Cyberman720/F1_GNSS/README.md

# F1_GNSS
Repo for developing the F1_Engine
The objective of this project is to develop a basic L1 GPS only receiver.

The steps are as follows:
  learn how the basics of GNSS and specifically GPS work from a theroy aspect.
    https://dsp.stackexchange.com/questions/91829/cdma-using-bpsk-demodulation
  
  prototype a GNSS siluation program in python.
    This has been an amazing resource for this:
    https://natronics.github.io/blag/2014/gps-prn/

  Learn about PCB design and what is required for really high frequency operation
    https://www.ti.com/amplifier-circuit/analog-engineers-pocket-reference-guide.html
    (also read the attached documents in the repo)

  Develop a working, reliable GPS only demodulation PCB
    https://easyeda.com/
    https://jlcpcb.com/parts?spm=Jlcpcb.smttopic

  Intergrate with arduino

  determine if I can run the engine direct on the arduino or if i need to process things on an external Rasberry pi
