Cyberman720/F1_GNSS/PCB_Designs/MK-IV/Screenshot 2025-08-05 094551.png

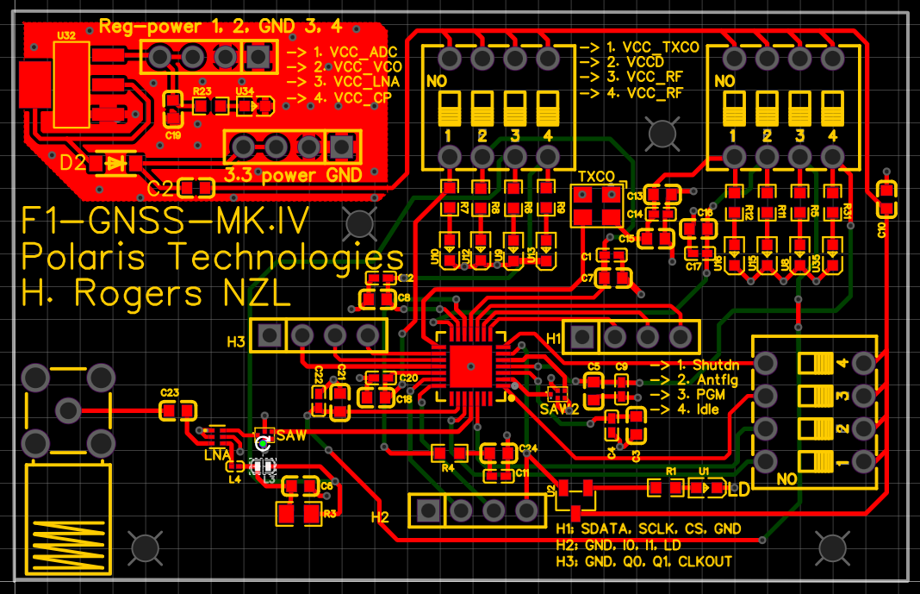
PCB_Designs/MK-IV/Screenshot 2025-08-05 094551.png
