Cyberman720/F1_GNSS/PCB_Designs/Mk_II/PCB_PCB_GNSS_F1_MK_II_2025-05-27.png

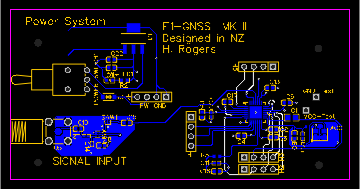
PCB_Designs/Mk_II/PCB_PCB_GNSS_F1_MK_II_2025-05-27.png
