Cyberman720/F1_GNSS/PCB_Designs/MK-IV/9117512A20250805.xlsx

Designator | Name | Footprint | Quantity
U6 | BWSMA-JWE | SMA-TH_BWSMA-JWE | 1
