Cyberman720/F1_GNSS/PCB_Designs/Mk_II/BOM_MKII-Diagram_2025-05-27.csv

ID | Name | Designator | Footprint | Quantity | Manufacturer Part | Manufacturer | Supplier | Supplier Part | Price | Pins | Contributor | JLCPCB Part Class
1 | 100nF | C1,C2,C3,C4,C5,C6,C10 | C0603 | 7 | CC0603KRX7R9BB104 | YAGEO(国巨) | LCSC | C14663 | 0.002 | 2 |  | Basic Part
2 | 10nF | C7 | C0603 | 1 | GRT1885C1E103FA02D | muRata(村田) | LCSC | C3836718 | 0.044 | 2 | lcsc | Extended Part
3 | 3pF | C8 | C0603 | 1 | CC0603BRNPO9BN3R0 | YAGEO(国巨) | LCSC | C519105 | 0.004 | 2 | LCSC | Extended Part
4 | 100pF | C9 | C0402 | 1 | CGA2B2C0G1H101JT0Y0F | TDK | LCSC | C76699 | 0.009 | 2 |  | Extended Part
5 | 27pF | C11 | C0402 | 1 | 0402N270J500CT | Walsin(华新科) | LCSC | C295973 | 0.001 | 2 | LCSC | Extended Part
6 | 22uF | C12 | C0603 | 1 | CL10A226MQ8NRNC | SAMSUNG(三星) | LCSC | C59461 | 0.009 | 2 |  | Basic Part
7 | 2pF | C13 | C0201 | 1 | 0201CG2R0C500NT | FH(风华) | LCSC | C233263 | 0.001 | 2 | LCSC | Extended Part
8 | SM4007PL | D1 | SOD-123F_L2.8-W1.8-LS3.7-RD | 1 | SM4007PL | MDD(辰达半导体) | LCSC | C64898 | 0.005 | 2 |  | Basic Part
9 | 2.54-1*4P母 | H1,H2,H3,H4,H5 | HDR-TH_4P-P2.54-V-F | 5 | 2.54-1*4P母 | BOOMELE(博穆精密) | LCSC | C2718488 | 0.047 | 4 | LCSC | Extended Part
10 | SAFEB1G57KE0F00R15 | L1 | FILTER-SMD_5P-L1.4-W1.1-L_HDF1588E-B2 | 1 | SAFEB1G57KE0F00R15 | muRata(村田) | LCSC | C91645 | 0.138 | 5 |  | Extended Part
11 | 10nH | L2 | L0402 | 1 | LQG15WZ10NJ02D | muRata(村田) | LCSC | C3911026 | 0.029 | 2 | lcsc | Extended Part
12 | 20pF | R1 | C0402 | 1 | TCC0402COG200J500AT | CCTC(三环) | LCSC | C880615 | 0.001 | 2 | lcsc | Extended Part
13 | 20kΩ | R2 | RES-TH_BD9.0-L31.5-P35.50-D0.8 | 1 | EWWR0008J20K0T9 | RESI(开步睿思) | LCSC | C349029 | 0.478 | 2 | LCSC | Extended Part
14 | 10kΩ | R23 | R0603 | 1 | 0603WAF1002T5E | UNI-ROYAL(厚声) | LCSC | C25804 | 0.001 | 2 |  | Basic Part
15 | ST-0-102-C03-N003-RS | SW1 | SW-TH_ST-0-102-C03-N003-RS | 1 | ST-0-102-C03-N003-RS | YUEN FUNG(源丰) | LCSC | C1788489 | 0.681 | 5 | LCSC | Extended Part
16 | - | U1 | QFN-28_L5.0-W5.0-P0.50-BL-EP3.3 | 1 | MAX2769BETI/V+T | ADI(亚德诺)/MAXIM(美信) | LCSC | C118482 | 3.757 | 29 | LCSC | Extended Part
17 | 470pF | U2,U6,U11 | CAP-SMD_L8.1-W6.0-LS11.4 | 3 | SMDY13225Y5P471K0 | STE(松田) | LCSC | C20625786 | 0.052 | 2 | lcsc | Extended Part
18 | AMS1117-3.3_C347222 | U3 | SOT-223-4_L6.5-W3.5-P2.30-LS7.0-BR | 1 | AMS1117-3.3 | UMW(友台半导体) | LCSC | C347222 | 0.04 | 4 | LCSC | Extended Part
19 | 470pF | U4 | C0402 | 1 | C1005NP02A471J050BA | TDK | LCSC | C3906083 | 0.017 | 2 | lcsc
20 | BWSMA-JWE | U5 | SMA-TH_BWSMA-JWE | 1 | BWSMA-JWE | BAT WIRELESS(蝙蝠无线) | LCSC | C5250065 | 0.824 | 5 | lcsc | Extended Part
21 | 16.368MHz | U8 | CRYSTAL-SMD_4P-L5.0-W3.2-BL | 1 | SA53216CF35HLR | CTS(西迪斯) | LCSC | C7071141 | 1.508 | 4 | lcsc | Extended Part
22 | AT2659 | U10 | DFN-6_L1.6-W1.0-P0.55-BL | 1 | AT2659 | 杭州中科微 | LCSC | C92450 | 0.102 | 6 | 立创EDA官方封装库 | Extended Part
23 | NCD0603Y5 | U34 | LED0603-RD | 1 | NCD0603Y5 | 国星光电 | LCSC | C7429912 | 0.007 | 2 | lcsc | Extended Part
