Cyberman720/F1_GNSS/PCB_Designs/Mk-I/BOM_GNSS-F1_2025-04-29.csv

ID | Name | Designator | Footprint | Quantity | Manufacturer Part | Manufacturer | Supplier | Supplier Part | Price | Pins | 3DModel | Contributor | JLCPCB Part Class | Value | link
1 | C0805 | C1 | C0805 | 1 | CL21B103KBANNNC | SAMSUNG(三星) | LCSC | C1710 | 0.006 | 2 | C0805_L2.0-W1.3-H1.3 | lcsc | Basic Part | 10nF | https://lcsc.com/eda_search?q=C1710&%26type=1&ref=editor
2 | C0603 | C15,C16,C17,C18,C19 | C0603 | 5 | 0603B471K500NT | FH(风华) | LCSC | C1620 | 0.003 | 2 | C0603_L1.6-W0.8-H0.8 | lcsc | Basic Part | 470pF | https://lcsc.com/eda_search?q=C1620&%26type=1&ref=editor
3 | SOD-123F_L2.8-W1.8-LS3.7-RD | D3,D1,D2 | SOD-123F_L2.8-W1.8-LS3.7-RD | 3 | SM4007PL | MDD(辰达半导体) | LCSC | C64898 | 0.005 | 2 | SOD-123FL_L2.8-W1.8-LS3.7-RD-1 | lcsc | Basic Part |  | https://lcsc.com/eda_search?q=C64898&%26type=1&ref=editor
4 | Header-Female-2.54_1x2 | P2,P1 | HDR-TH_2P-P2.54-V-F | 2 | 2.54-1*2P母 | BOOMELE(博穆精密) | LCSC | C49661 | 0.037 | 2 | HDR-TH_2P-P2.54-F-LI-1X2P | lcsc | Extended Part |  | https://item.szlcsc.com/426418.html
5 | R0603 | R5 | R0603 | 1 | 0603WAF2002T5E | UNI-ROYAL(厚声) | LCSC | C4184 | 0.001 | 2 | R0603 | lcsc | Basic Part | 20kΩ | https://lcsc.com/eda_search?q=C4184&%26type=1&ref=editor
6 | C0402 | C20 | C0402 | 1 | 0402CG101J500NT | FH(风华) | LCSC | C1546 | 0.001 | 2 | C0402_L1.0-W0.5-H0.5 | lcsc | Basic Part | 100pF | https://lcsc.com/eda_search?q=C1546&%26type=1&ref=editor
7 | C0402 | C21 | C0402 | 1 | 0402CG200J500NT | FH(风华) | LCSC | C1554 | 0.001 | 2 | C0402_L1.0-W0.5-H0.5 | lcsc | Basic Part | 20pF | https://lcsc.com/eda_search?q=C1554&%26type=1&ref=editor
8 | 2.54-1*4P母 | H2,H3,H1 | HDR-TH_4P-P2.54-V-F | 3 | 2.54-1*4P母 | BOOMELE(博穆精密) | LCSC | C2718488 | 0.046 | 4 | HDR-TH_4P-P2.54-F-LI-1X4P | LCSC | Extended Part |  | https://item.szlcsc.com/523021.html
9 | C0603 | C22 | C0603 | 1 | CL10A226MQ8NRNC | SAMSUNG(三星) | LCSC | C59461 | 0.008 | 2 | C0603_L1.6-W0.8-H0.8 | lcsc | Basic Part | 22uF | https://lcsc.com/eda_search?q=C59461&%26type=1&ref=editor
10 | LED0603-RD | PW-LED | LED0603-RD | 1 | NCD0603Y5 | 国星光电 | LCSC | C7429912 | 0.007 | 2 | LED0603-RD | lcsc | Extended Part |  | https://lcsc.com/eda_search?q=C7429912&%26type=1&ref=editor
11 | R0603 | R2 | R0603 | 1 | 0603WAF1002T5E | UNI-ROYAL(厚声) | LCSC | C25804 | 0.001 | 2 | R0603 | lcsc | Basic Part | 10kΩ | https://lcsc.com/eda_search?q=C25804&%26type=1&ref=editor
12 | L0402 | L2 | L0402 | 1 | LQG15WZ10NJ02D | muRata(村田) | LCSC | C3911026 | 0.034 | 2 | L0402_L1.0-W0.5-H0.5_BEAD | lcsc | Extended Part | 10nH | https://lcsc.com/eda_search?q=C3911026&%26type=1&ref=editor
13 | C0201 | C14 | C0201 | 1 | 0201CG2R0C500NT | FH(风华) | LCSC | C233263 | 0.001 | 2 | C0201_L0.6-W0.3-H0.3 | lcsc | Extended Part | 2pF | https://lcsc.com/eda_search?q=C233263&%26type=1&ref=editor
14 | 100nF | C13,C2,C3,C4,C5,C6,C10 | C0603 | 7 | CC0603KRX7R9BB104 | YAGEO(国巨) | LCSC | C14663 | 0.002 | 2 | C0603_L1.6-W0.8-H0.8 | lcsc | Basic Part |  | https://item.szlcsc.com/362304.html
15 | 2462 | BAT1,BAT2 | BAT-TH_2P-P14.50_2462 | 2 | 2462 | Keystone | LCSC | C3029547 | 1.375 | 2 | BAT-TH_2P-P14.50_2462 | lcsc | Extended Part |  | https://atta.szlcsc.com/upload/public/pdf/source/20220627/187200C29C302DEABB66D4671A482C2E.pdf
16 | 3pF | C8 | C0603 | 1 | CC0603BRNPO9BN3R0 | YAGEO(国巨) | LCSC | C519105 | 0.004 | 2 | C0603_L1.6-W0.8-H0.8 | LCSC | Extended Part |  | https://item.szlcsc.com/362304.html
17 | 27pF | C11 | C0402 | 1 | 0402N270J500CT | Walsin(华新科) | LCSC | C295973 | 0.001 | 2 | C0402_L1.0-W0.5-H0.5 | LCSC | Extended Part |  | https://item.szlcsc.com/15869.html
18 | SAFEB1G57KE0F00R15 | SAW | FILTER-SMD_5P-L1.4-W1.1-L_HDF1588E-B2 | 1 | SAFEB1G57KE0F00R15 | muRata(村田) | LCSC | C91645 | 0.148 | 5 | FILTER-SMD_5P-L1.4-W1.1-L_HDF1588E-B2 | LCSC | Extended Part |  | https://atta.szlcsc.com/upload/public/pdf/source/20191209/C468489_0AC4193B38E9111468D3A091E4B3D1AF.pdf
19 | ST-0-102-C03-N003-RS | POWER-SWITCH | SW-TH_ST-0-102-C03-N003-RS | 1 | ST-0-102-C03-N003-RS | YUEN FUNG(源丰) | LCSC | C1788489 | 0.675 | 5 | SW-TH_ST-0-102-C03-N003-RS | LCSC | Extended Part |  | https://item.szlcsc.com/1879280.html
20 | DSWB04LHGET | SOURCE-SELECT,SW3 | SW-TH_DSWB04LHGET | 2 | DSWB04LHGET | YE | LCSC | C99418 | 0.184 | 8 | SW-TH_DS-04 | LCSC | Extended Part |  | https://item.szlcsc.com/100632.html
21 | - | U1 | QFN-28_L5.0-W5.0-P0.50-BL-EP3.3 | 1 | MAX2769BETI/V+T | ADI(亚德诺)/MAXIM(美信) | LCSC | C118482 | 2.074 | 29 | QFN-28_L5.0-W5.0-H0.9-P0.50 | LCSC | Extended Part |  | https://item.szlcsc.com/245064.html
22 | BWSMA-JWE | U5 | SMA-TH_BWSMA-JWE | 1 | BWSMA-JWE | BAT WIRELESS(蝙蝠无线) | LCSC | C5250065 | 0.824 | 5 | SMA-TH_BWSMA-JWE | lcsc | Extended Part |  | https://atta.szlcsc.com/upload/public/pdf/source/20221109/3868545A0A3A2D66F7603AE72F0DD644.pdf
23 | 16.368MHz | U8 | CRYSTAL-SMD_4P-L5.0-W3.2-BL | 1 | SA53216CF35HLR | CTS(西迪斯) | LCSC | C7071141 | 1.508 | 4 | CRYSTAL-SMD_4P-L5.0-W3.2-BL | lcsc | Extended Part |  | https://item.szlcsc.com/538990.html
24 | AT2659 | AMP | DFN-6_L1.6-W1.0-P0.55-BL | 1 | AT2659 | 杭州中科微 | LCSC | C92450 | 0.101 | 6 | DFN-6_L1.5-W1.0-H0.7-P0.50 | 立创EDA官方封装库 | Extended Part |  | https://item.szlcsc.com/93643.html
25 | AMS1117-3.3_C347222 | U12 | SOT-223-4_L6.5-W3.5-P2.30-LS7.0-BR | 1 | AMS1117-3.3 | UMW(友台半导体) | LCSC | C347222 | 0.039 | 4 | SOT-223-4P_L6.5-W3.5-H1.6-LS7.0-P2.30 | LCSC | Extended Part |  | https://item.szlcsc.com/84517.html
26 | GT-USB-7055CB | USB1 | USB-C-TH_GT-USB-7055BB | 1 | GT-USB-7055CB | G-Switch(品赞) | LCSC | C22383828 | 0.516 | 20 | USB-C-TH_GT-USB-7055BB | lcsc | Extended Part |  | https://atta.szlcsc.com/upload/public/pdf/source/20230712/E9AF0CD94CC9418EF2FC92B45933B86F.pdf
