Cyberman720/F1_GNSS/PCB_Designs/MK-IV/Schematic_MK-IV_2025-08-04.pdf

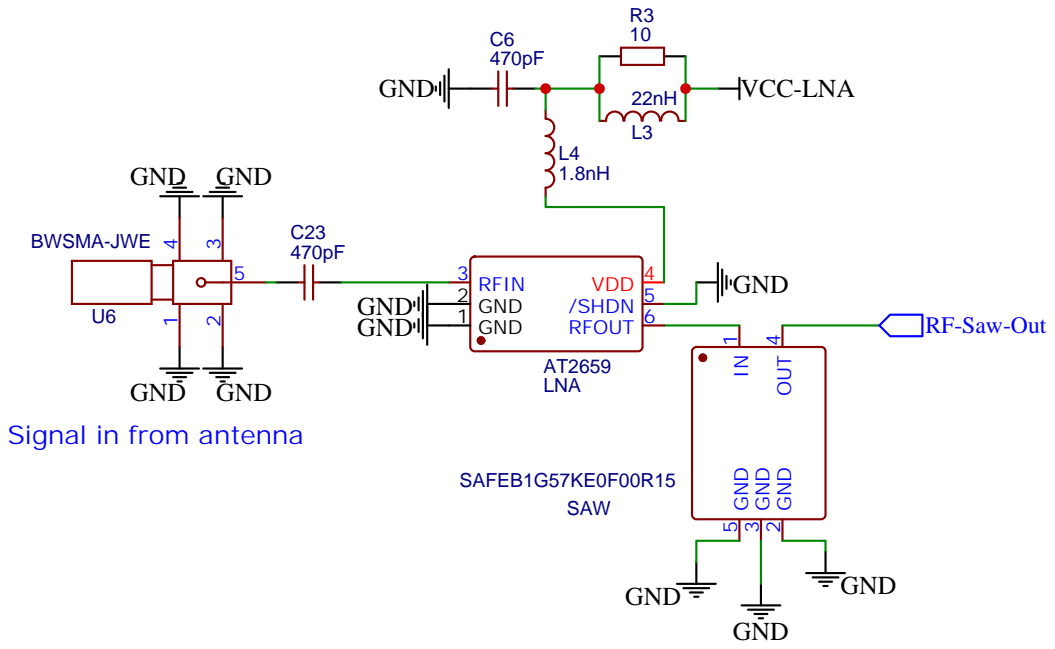
[picture p3: page 1]

Signal in from antenna

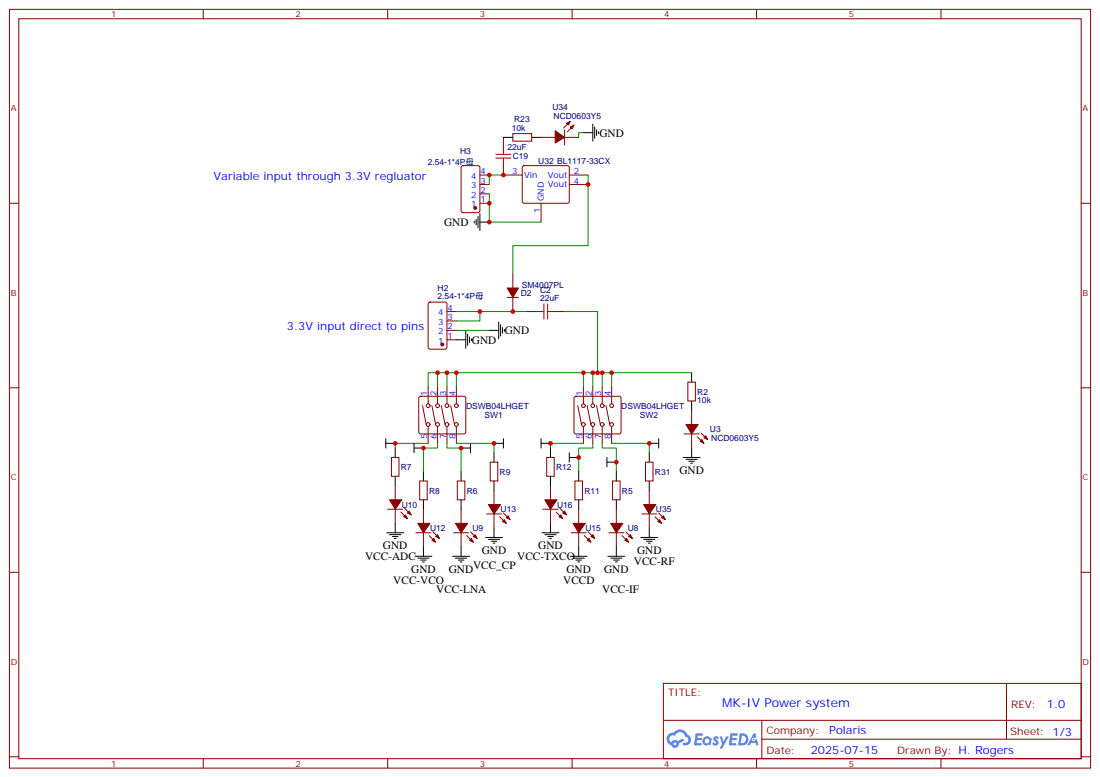
[picture p4: page 2]

Variable input through 3.3V regluator

3.3V input direct to pins

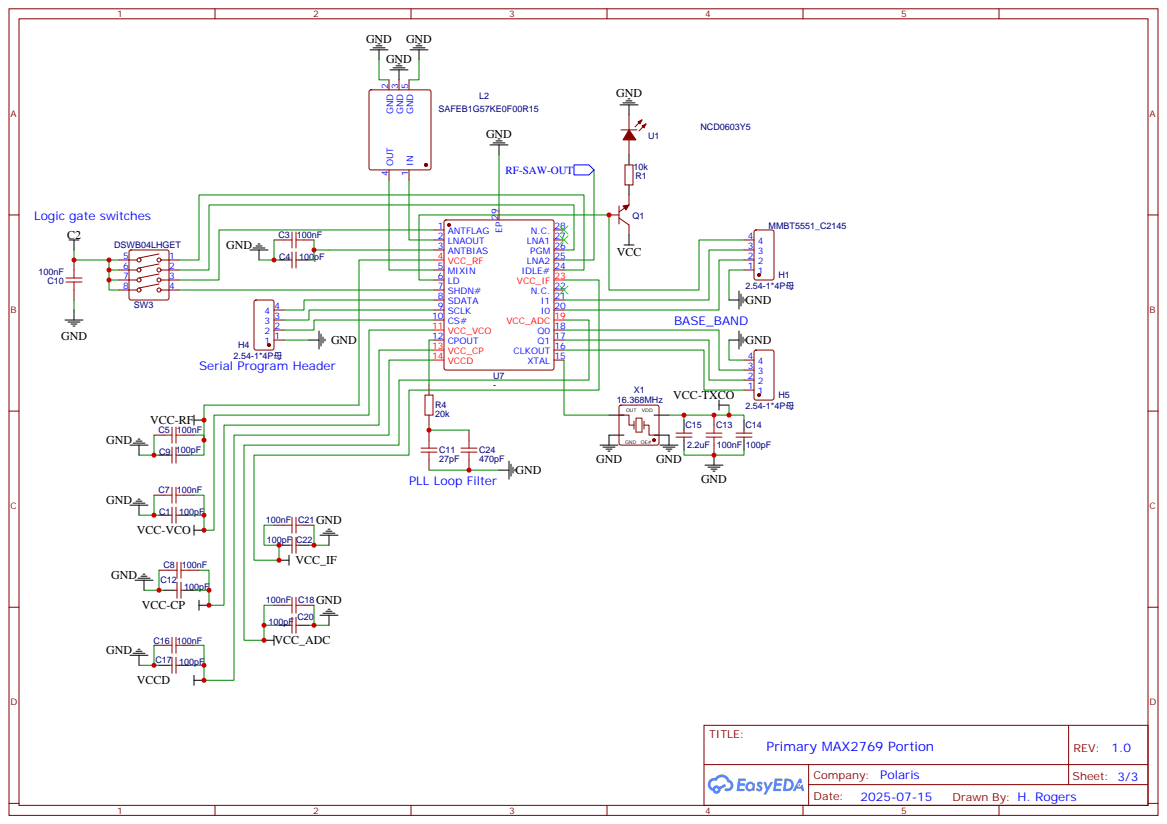
[picture p5: page 3]
