Cyberman720/F1_GNSS/PCB_Designs/MK-III/Schematic_F1_GNSS_MK_III_2025-04-22.pdf

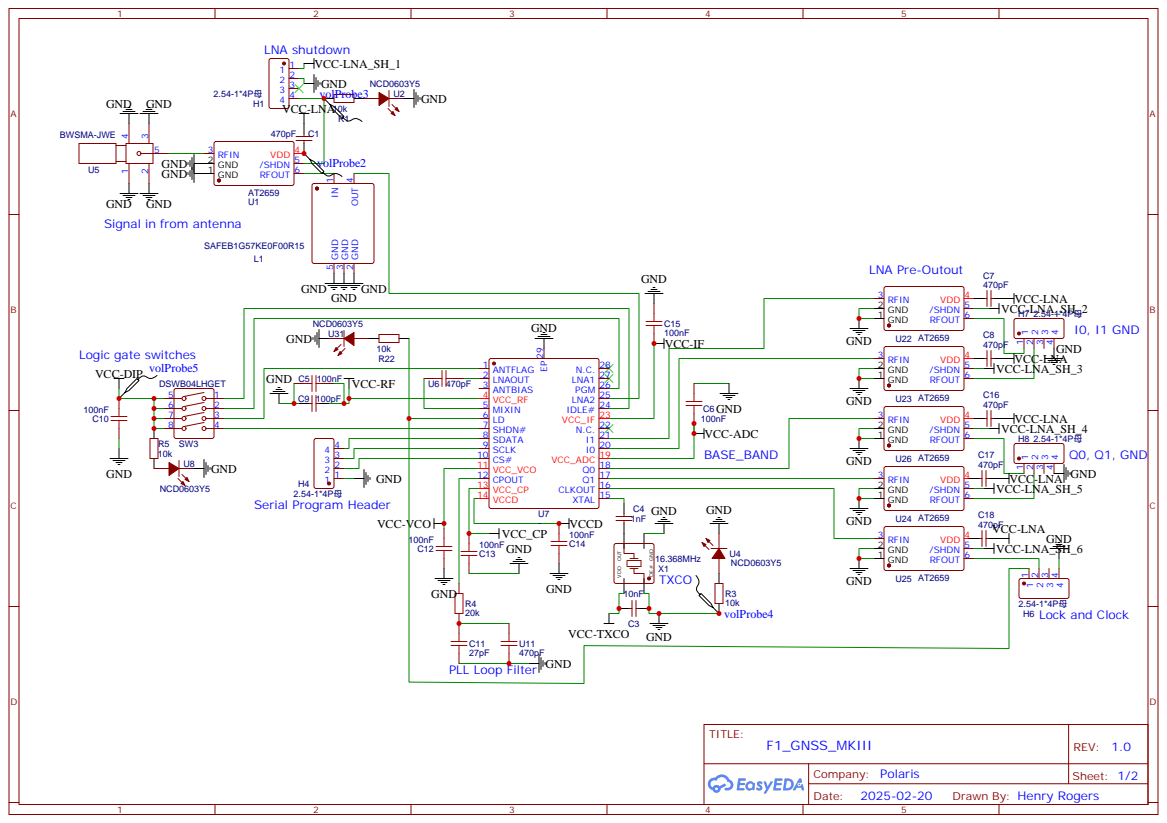
[picture p6: page 1]

GND
Signal in from antenna

Drawn By: Henry Rogers

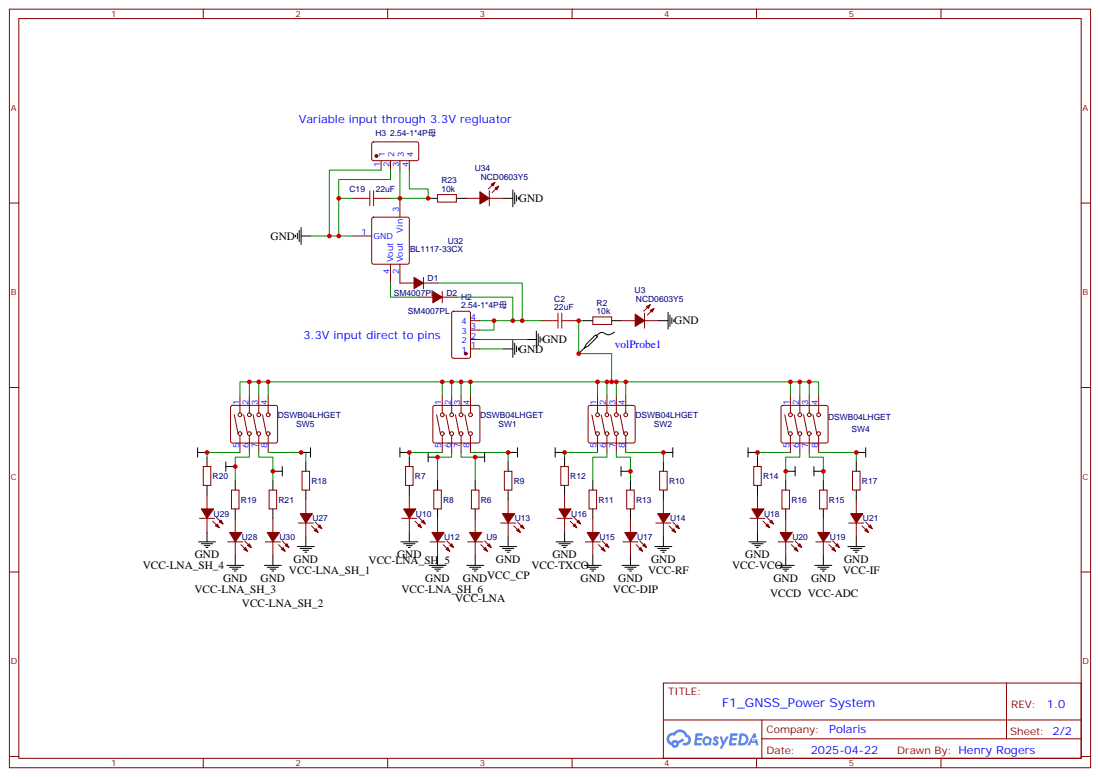
[picture p7: page 2]

Variable input through 3.3V regluator

3.3V input direct to pins

Drawn By: Henry Rogers
