Cyberman720/F1_GNSS/PCB_Designs/Mk-I/Schematic_GNSS-F1_2025-04-29.pdf

# USB1EH ¹⁷

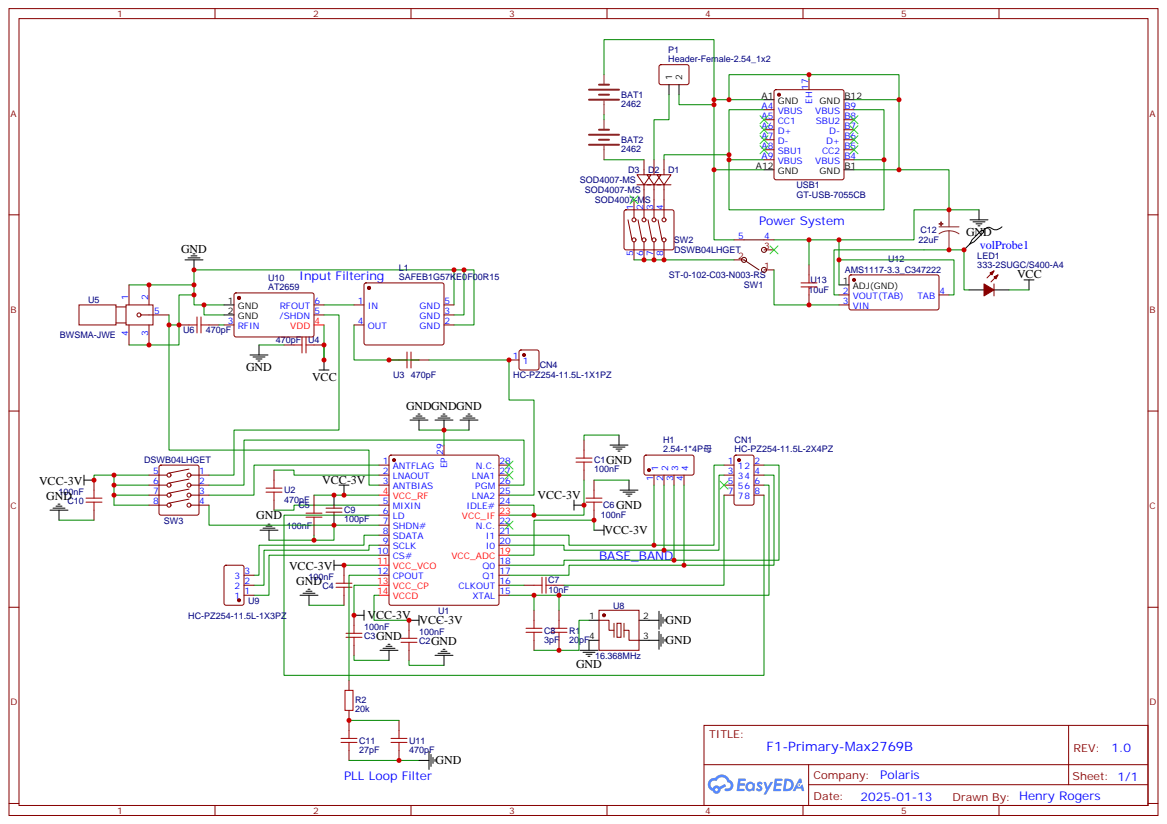
[picture p8: page 1]

GND B1 GND A12 VBUS A9 SBU1 A8 D- A7 D+ A6 CC1 A5 VBUS A4 GND A1
