Cyberman720/F1_GNSS/(list of files, drawings)

Other design files:
PCB_Designs/Mk-I/PCB_PCB_GNSS_F1_MK_I_2025-04-29.json
