Cyberman720/F1_GNSS/(commit log)

2025-04-28 The existing Arduino code
2025-05-20 Add files via upload
    SPI Programming for the F1 MAX2769
2025-08-04 Add files via upload
    revision of current PCB
    [BOM_MK-IV_2025-08-04.csv, PCB_PCB_MK-IV_2025-08-04.json]
2025-08-04 Add files via upload
    These are the actual production files I used
    I used JLC and got them to assemble it
    [9117512A20250805.xlsx, PickAndPlace_PCB_MK-IV_2025-08-05.csv]
2025-08-04 Add files via upload
    The pcb view of MK IV
2026-04-14 Add files via upload
    Adding in the work done to program the PIO on the pico
